haxeko/h2-thread-button/hardware-chip/fab/bom-jlcpcb.csv

Comment | Designator | Footprint | LCSC Part # | Manufacturer Part Number
22uF | C4 | 0603 | C59461 | CL10A226MQ8NRNC
1nF | C8 | 0402 | C1523 | 0402B102K500NT
10nF | C12 | 0402 | C15195 | CL05B103KB5NNNC
220uF | C1,C2 | 1210 | C469553 | GRM32ER60J227ME05L
18pF | C18,C19,C20,C21 | 0402 | C1549 | 0402CG180J500NT
1.5pF | C22,C23 | 0402 | C76957 | GRM1555C1H1R5BA01D
10uF | C3,C5,C6 | 0603 | C19702 | CL10A106KP8NNNC
1uF | C7,C10,C13 | 0402 | C52923 | CL05A105KA5NQNC
100nF | C9,C11,C14,C15,C16,C17,C26 | 0402 | C1525 | CL05B104KO5NNNC
XL-2121RGBC-WS2812B | D1 | SMD 2.1x2.1mm RGB LED | C5349957 | XL-2121RGBC-WS2812B
2.2uH | L1 | 1008 | C391305 | DFE252012P-2R2M=P2
24nH | L2 | 0402 | C74301 | SDCL1005C24NJTDF
2.4nH | L3 | 0402 | C97997 | LQG15HS2N4S02D
AO3401A | Q1,Q2 | SOT-23 | C15127 | AO3401A
36.5k | R1 | 0402 | C49010116 | FRC0402F3652TS
1k | R7 | 0402 | C11702 | 0402WGF1001TCE
100k | R8 | 0402 | C25741 | 0402WGF1003TCE
510R | R10 | 0402 | C25123 | 0402WGF5100TCE
100R | R12 | 0402 | C25076 | 0402WGF1000TCE
0R | R2,R3,R11 | 0402 | C17168 | 0402WGF0000TCE
10k | R4,R5 | 0402 | C25744 | 0402WGF1002TCE
1M | R6,R9 | 0402 | C26083 | 0402WGF1004TCE
PTS810 | SW1 | SMD 4.2x3.2mm tact switch | C116501 | PTS810 SJM 250 SMTR LFS
ESP32-H2FH4 | U1 | QFN-32 4x4mm | C22470214 | ESP32-H2FH4
TPS63900DSKR | U2 | WSON-10 2.5x2.5mm | C1518762 | TPS63900DSKR
32MHz | Y1 | SMD3225-4P | C90923 | 7M32000035
32.768kHz | Y2 | SMD3215-2P | C32346 | Q13FC13500004
