haxeko/h2-thread-button/hardware/fab/bom.csv

Qty | Designator | Value | Footprint | MPN | LCSC | Description | DNP
1 | BT1 | CR2032 | matter_button:BatteryHolder_Keystone_3034_CR2032 | Keystone 3034 |  | CR2032 holder, SMT
1 | C4 | 22uF | Capacitor_SMD:C_0603_1608Metric | CL10A226MQ8NRNC | C59461 | 6.3 V X5R, at U2 VOUT
1 | C7 | 1uF | Capacitor_SMD:C_0402_1005Metric | CL05A105KA5NQNC | C52923 | EN delay, not fitted | DNP
1 | C8 | 1nF | Capacitor_SMD:C_0402_1005Metric | CL05B102KB5NNNC | C1523 | 50 V X7R, button filter
2 | C1,C2 | 220uF | Capacitor_SMD:C_1210_3225Metric | GRM32ER60J227ME05L | C469553 | 6.3 V X5R bulk
2 | C3,C5 | 10uF | Capacitor_SMD:C_0603_1608Metric | CL10A106KP8NNNC | C19702 | 10 V X5R, at U1 pin 1,10 V X5R, at U2 VIN
2 | C6,C9 | 100nF | Capacitor_SMD:C_0402_1005Metric | CL05B104KO5NNNC | C1525 | 16 V X7R, VBAT sense filter,16 V X7R, at U1 pin 1
1 | D1 | red | LED_SMD:LED_0603_1608Metric | KT-0603R | C2286 | Hubei KENTO 0603 red
1 | L1 | 2.2uH | Inductor_SMD:L_1008_2520Metric | DFE252012P-2R2M=P2 | C391305 | Murata 2.5x2.0 mm, Isat 3 A
1 | Q1 | AO3401A | Package_TO_SOT_SMD:SOT-23 | AO3401A | C15127 | P-MOSFET -30 V, reverse polarity protection
1 | R1 | 36.5k | Resistor_SMD:R_0402_1005Metric | FRC0402F3652TS | C49010116 | 1 %, CFG1: VO(2) 3.3 V
2 | R2,R3 | 0R | Resistor_SMD:R_0402_1005Metric | 0402WGF0000TCE | C17168 | CFG2: no input current limit,CFG3: VO(1) 1.8 V, unused (SEL = VIN selects VO(2))
2 | R4,R5 | 10k | Resistor_SMD:R_0402_1005Metric | 0402WGF1002TCE | C25744 | EN pull-up,GPIO8 strapping pull-up
2 | R6,R9 | 1M | Resistor_SMD:R_0402_1005Metric | 0402WGF1004TCE | C26083 | VBAT sense, no divider,button pull-up
2 | R7,R8 | 1k | Resistor_SMD:R_0402_1005Metric | 0402WGF1001TCE | C11702 | LED series,button series
1 | SW1 | PTS810 | Button_Switch_SMD:SW_SPST_PTS810 | PTS810 SJM 250 SMTR LFS | C116501 | C&K 4.2x3.2 mm tact switch, 160 gf
1 | U1 | ESP32-H2-WROOM-02C-H4S | matter_button:ESP32-H2-WROOM-02C | ESP32-H2-WROOM-02C-H4S |  | Thread/BLE module, 4 MB flash
1 | U2 | TPS63900DSKR | Package_SON:WSON-10-1EP_2.5x2.5mm_P0.5mm_EP1.2x2mm | TPS63900DSKR | C1518762 | Buck-boost 1.8-5.5 V in, 75 nA Iq
