haxeko/h2-thread-button/hardware-chip/matter-button-cr2032-chip.kicad_pcb

## KiCad design hardware-chip/matter-button-cr2032-chip.kicad_pcb (2026-10-29)

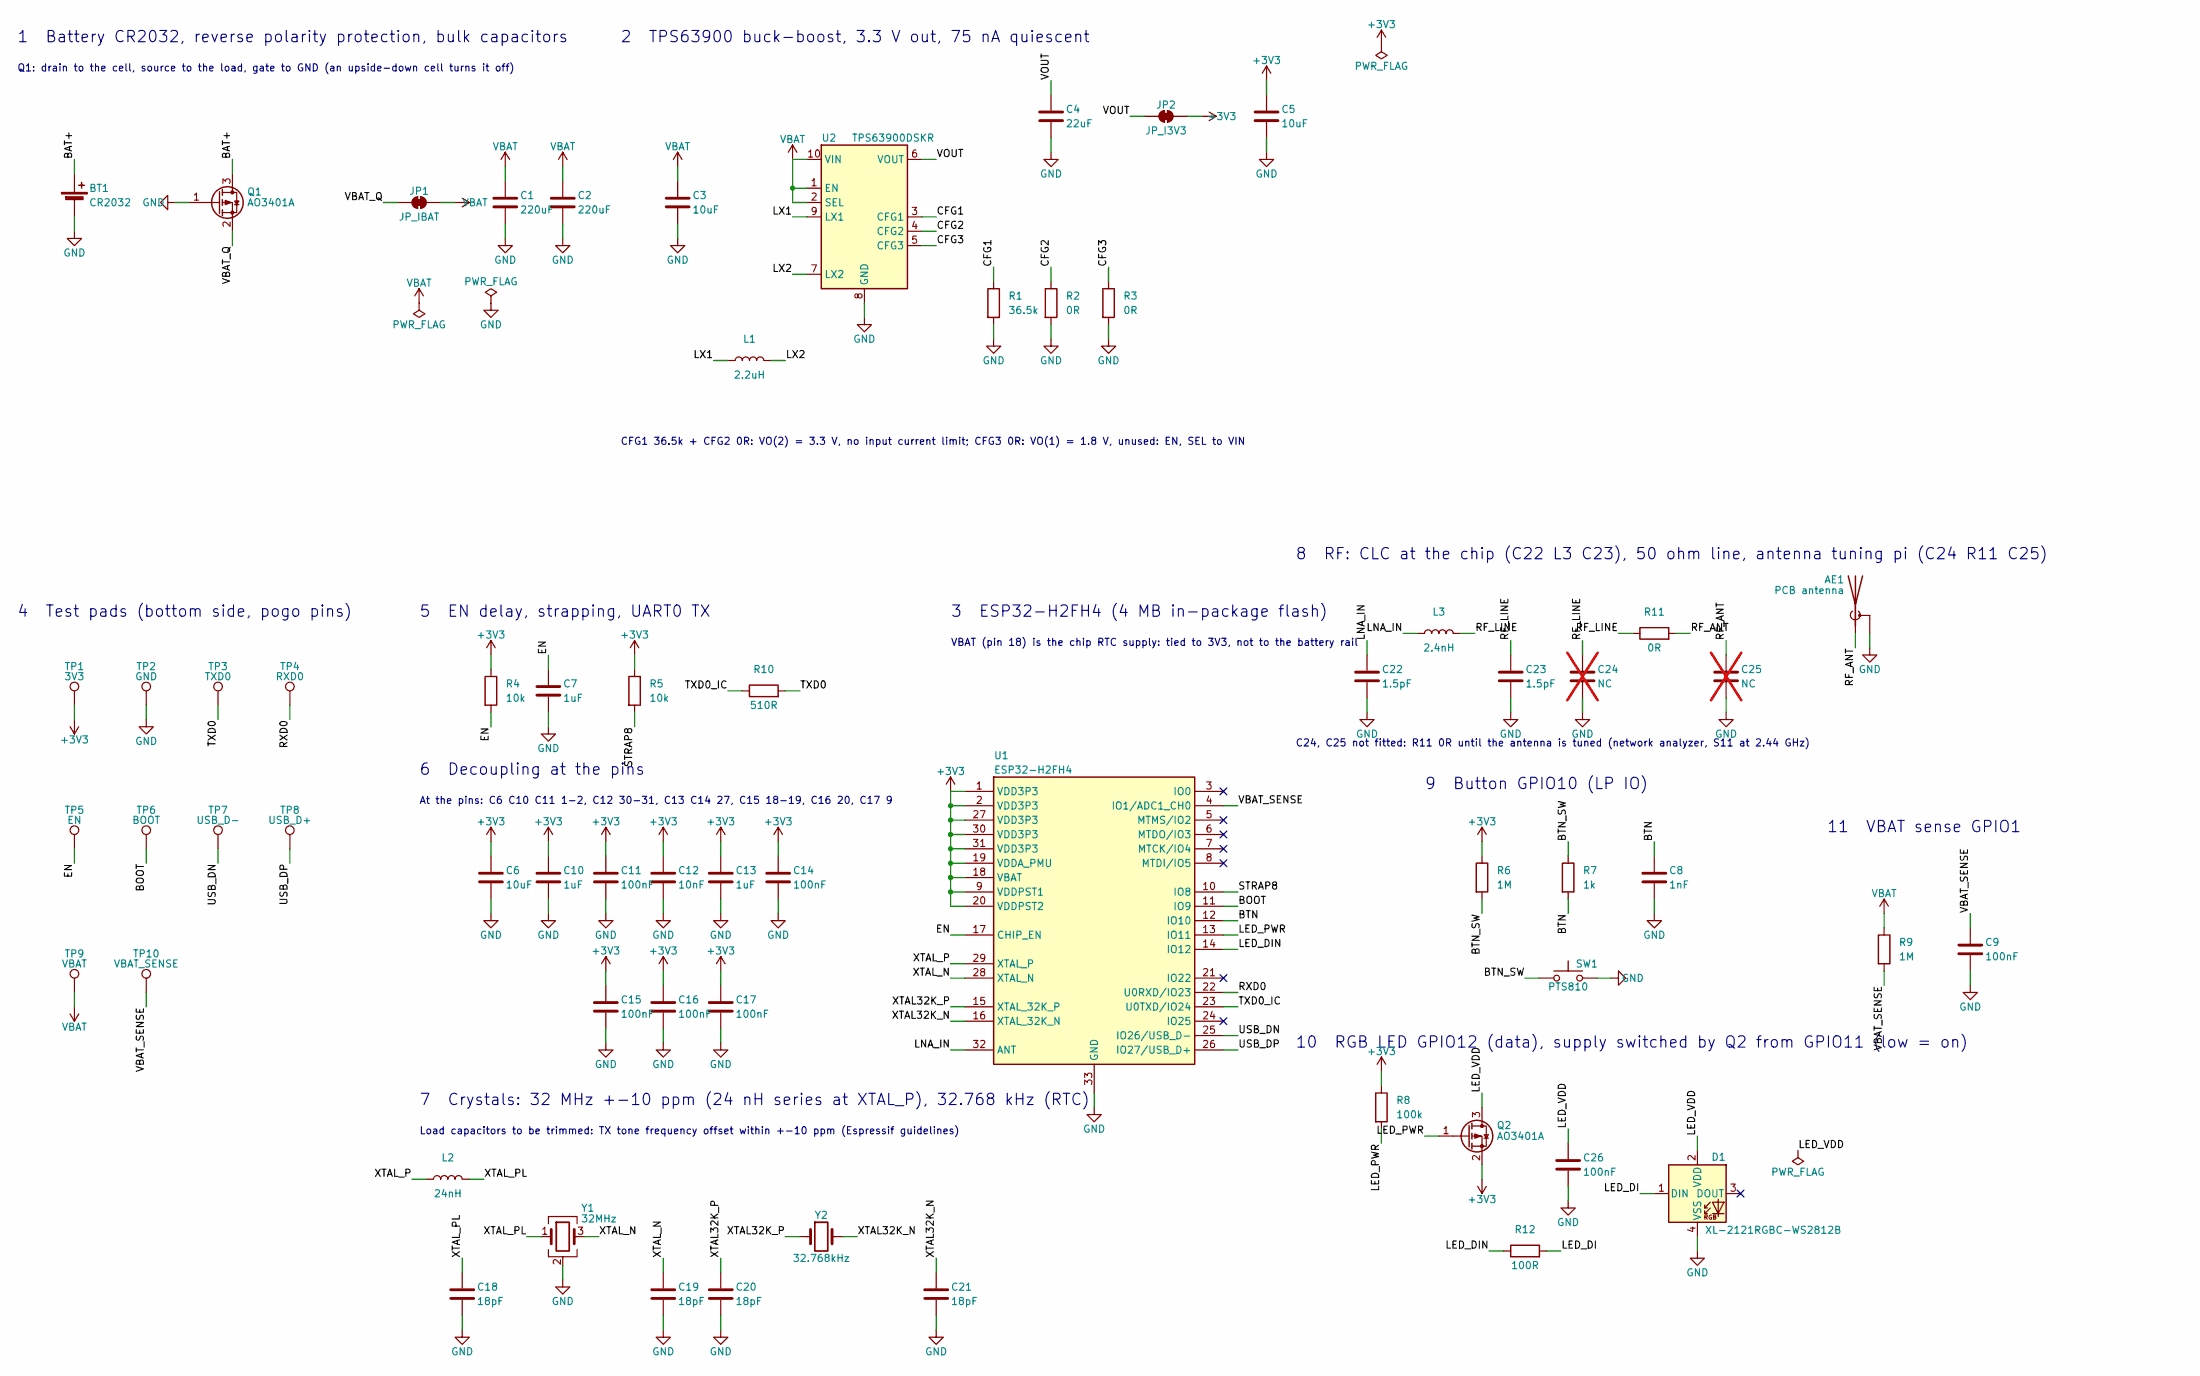
[picture p8: schematic matter-button-cr2032-chip.kicad_sch, ESP32-H2 Matter over Thread CR2032 button, chip and PCB ant…]

Parts:
AE1: PCB antenna; ANT_MIFA_TI-AN043
BT1: CR2032; BatteryHolder_Keystone_3034_CR2032; MPN Keystone 3034
C1, C2: 220uF; C_1210_3225Metric; MPN GRM32ER60J227ME05L; LCSC C469553
C3, C5, C6: 10uF; C_0603_1608Metric; MPN CL10A106KP8NNNC; LCSC C19702
C4: 22uF; C_0603_1608Metric; MPN CL10A226MQ8NRNC; LCSC C59461
C7, C10, C13: 1uF; C_0402_1005Metric; MPN CL05A105KA5NQNC; LCSC C52923
C8: 1nF; C_0402_1005Metric; MPN 0402B102K500NT; LCSC C1523
C9, C11, C14, C15, C16, C17, C26: 100nF; C_0402_1005Metric; MPN CL05B104KO5NNNC; LCSC C1525
C12: 10nF; C_0402_1005Metric; MPN CL05B103KB5NNNC; LCSC C15195
C18, C19, C20, C21: 18pF; C_0402_1005Metric; MPN 0402CG180J500NT; LCSC C1549
C22, C23: 1.5pF; C_0402_1005Metric; MPN GRM1555C1H1R5BA01D; LCSC C76957
C24, C25: NC; C_0402_1005Metric; not fitted
D1: XL-2121RGBC-WS2812B; LED_XL-2121RGBC-WS2812B_2.1x2.1mm; MPN XL-2121RGBC-WS2812B; LCSC C5349957
JP1: JP_IBAT; SolderJumper-2_P1.3mm_Bridged_RoundedPad1.0x1.5mm
JP2: JP_I3V3; SolderJumper-2_P1.3mm_Bridged_RoundedPad1.0x1.5mm
L1: 2.2uH; L_1008_2520Metric; MPN DFE252012P-2R2M=P2; LCSC C391305
L2: 24nH; L_0402_1005Metric; MPN SDCL1005C24NJTDF; LCSC C74301
L3: 2.4nH; L_0402_1005Metric; MPN LQG15HS2N4S02D; LCSC C97997
Q1, Q2: AO3401A; SOT-23; MPN AO3401A; LCSC C15127
R1: 36.5k; R_0402_1005Metric; MPN FRC0402F3652TS; LCSC C49010116
R2, R3, R11: 0R; R_0402_1005Metric; MPN 0402WGF0000TCE; LCSC C17168
R4, R5: 10k; R_0402_1005Metric; MPN 0402WGF1002TCE; LCSC C25744
R6, R9: 1M; R_0402_1005Metric; MPN 0402WGF1004TCE; LCSC C26083
R7: 1k; R_0402_1005Metric; MPN 0402WGF1001TCE; LCSC C11702
R8: 100k; R_0402_1005Metric; MPN 0402WGF1003TCE; LCSC C25741
R10: 510R; R_0402_1005Metric; MPN 0402WGF5100TCE; LCSC C25123
R12: 100R; R_0402_1005Metric; MPN 0402WGF1000TCE; LCSC C25076
SW1: PTS810; SW_SPST_PTS810; MPN PTS810 SJM 250 SMTR LFS; LCSC C116501
TP1: 3V3; TestPoint_Pad_D1.0mm
TP2: GND; TestPoint_Pad_D1.0mm
TP3: TXD0; TestPoint_Pad_D1.0mm
TP4: RXD0; TestPoint_Pad_D1.0mm
TP5: EN; TestPoint_Pad_D1.0mm
TP6: BOOT; TestPoint_Pad_D1.0mm
TP7: USB_D-; TestPoint_Pad_D1.0mm
TP8: USB_D+; TestPoint_Pad_D1.0mm
TP9: VBAT; TestPoint_Pad_D1.0mm
TP10: VBAT_SENSE; TestPoint_Pad_D1.0mm
U1: ESP32-H2FH4; ESP32-H2_QFN-32-1EP_4x4mm_P0.4mm; MPN ESP32-H2FH4; LCSC C22470214
U2: TPS63900DSKR; WSON-10-1EP_2.5x2.5mm_P0.5mm_EP1.2x2mm; MPN TPS63900DSKR; LCSC C1518762
Y1: 32MHz; Crystal_SMD_3225-4Pin_3.2x2.5mm; MPN 7M32000035; LCSC C90923
Y2: 32.768kHz; Crystal_SMD_3215-2Pin_3.2x1.5mm; MPN Q13FC13500004; LCSC C32346

Connections:
+3V3: C5.1, C6.1, C10.1, C11.1, C12.1, C13.1, C14.1, C15.1, C16.1, C17.1, JP2.2 (B), Q2.2 (S), R4.1, R5.1, R6.1, R8.1, TP1.1, U1.1 (VDD3P3), U1.2 (VDD3P3), U1.9 (VDDPST1), U1.18 (VBAT), U1.19 (VDDA_PMU), U1.20 (VDDPST2), U1.27 (VDD3P3), U1.30 (VDD3P3), U1.31 (VDD3P3)
/BAT+: BT1.1 (+), Q1.3 (D)
/BOOT: TP6.1, U1.11 (IO9)
/BTN: C8.1, R7.2, U1.12 (IO10)
/BTN_SW: R6.2, R7.1, SW1.1
/CFG1: R1.1, U2.3 (CFG1)
/CFG2: R2.1, U2.4 (CFG2)
/CFG3: R3.1, U2.5 (CFG3)
/EN: C7.1, R4.2, TP5.1, U1.17 (CHIP_EN)
/LED_DI: D1.1 (DIN), R12.2
/LED_DIN: R12.1, U1.14 (IO12)
/LED_PWR: Q2.1 (G), R8.2, U1.13 (IO11)
/LED_VDD: C26.1, D1.2 (VDD), Q2.3 (D)
/LNA_IN: C22.1, L3.1, U1.32 (ANT)
/LX1: L1.1, U2.9 (LX1)
/LX2: L1.2, U2.7 (LX2)
/RF_ANT: AE1.1 (A), C25.1, R11.2
/RF_LINE: C23.1, C24.1, L3.2, R11.1
/RXD0: TP4.1, U1.22 (U0RXD/IO23)
/STRAP8: R5.2, U1.10 (IO8)
/TXD0: R10.2, TP3.1
/TXD0_IC: R10.1, U1.23 (U0TXD/IO24)
/USB_DN: TP7.1, U1.25 (IO26/USB_D-)
/USB_DP: TP8.1, U1.26 (IO27/USB_D+)
/VBAT_Q: JP1.1 (A), Q1.2 (S)
/VBAT_SENSE: C9.1, R9.2, TP10.1, U1.4 (IO1/ADC1_CH0)
/VOUT: C4.1, JP2.1 (A), U2.6 (VOUT)
/XTAL32K_N: C21.1, U1.16 (XTAL_32K_N), Y2.2
/XTAL32K_P: C20.1, U1.15 (XTAL_32K_P), Y2.1
/XTAL_N: C19.1, U1.28 (XTAL_N), Y1.3
/XTAL_P: L2.1, U1.29 (XTAL_P)
/XTAL_PL: C18.1, L2.2, Y1.1
GND: AE1.2 (Shield), BT1.2 (-), C1.2, C2.2, C3.2, C4.2, C5.2, C6.2, C7.2, C8.2, C9.2, C10.2, C11.2, C12.2, C13.2, C14.2, C15.2, C16.2, C17.2, C18.2, C19.2, C20.2, C21.2, C22.2, C23.2, C24.2, C25.2, C26.2, D1.4 (VSS), Q1.1 (G), R1.2, R2.2, R3.2, SW1.2, TP2.1, U1.33 (GND), U2.8 (GND), U2.11 (GND), Y1.2 (G), Y1.4 (G)
VBAT: C1.1, C2.1, C3.1, JP1.2 (B), R9.1, TP9.1, U2.1 (EN), U2.2 (SEL), U2.10 (VIN)

Notes on the sheet:
1 Battery CR2032, reverse polarity protection, bulk capacitors
Q1: drain to the cell, source to the load, gate to GND (an upside-down cell turns it off)
2 TPS63900 buck-boost, 3.3 V out, 75 nA quiescent
CFG1 36.5k + CFG2 0R: VO(2) = 3.3 V, no input current limit; CFG3 0R: VO(1) = 1.8 V, unused: EN, SEL to VIN
4 Test pads (bottom side, pogo pins)
5 EN delay, strapping, UART0 TX
6 Decoupling at the pins
At the pins: C6 C10 C11 1-2, C12 30-31, C13 C14 27, C15 18-19, C16 20, C17 9
7 Crystals: 32 MHz +-10 ppm (24 nH series at XTAL_P), 32.768 kHz (RTC)
Load capacitors to be trimmed: TX tone frequency offset within +-10 ppm (Espressif guidelines)
3 ESP32-H2FH4 (4 MB in-package flash)
VBAT (pin 18) is the chip RTC supply: tied to 3V3, not to the battery rail
8 RF: CLC at the chip (C22 L3 C23), 50 ohm line, antenna tuning pi (C24 R11 C25)
C24, C25 not fitted: R11 0R until the antenna is tuned (network analyzer, S11 at 2.44 GHz)
9 Button GPIO10 (LP IO)
11 VBAT sense GPIO1
10 RGB LED GPIO12 (data), supply switched by Q2 from GPIO11 (low = on)

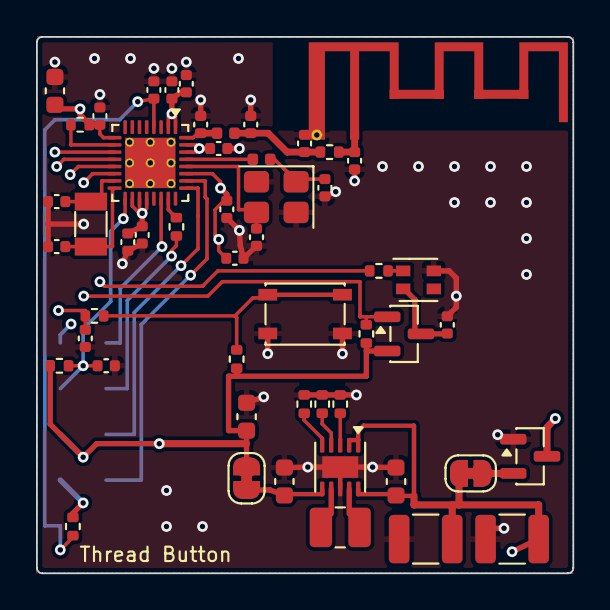
[picture p9: board matter-button-cr2032-chip.kicad_pcb from above]

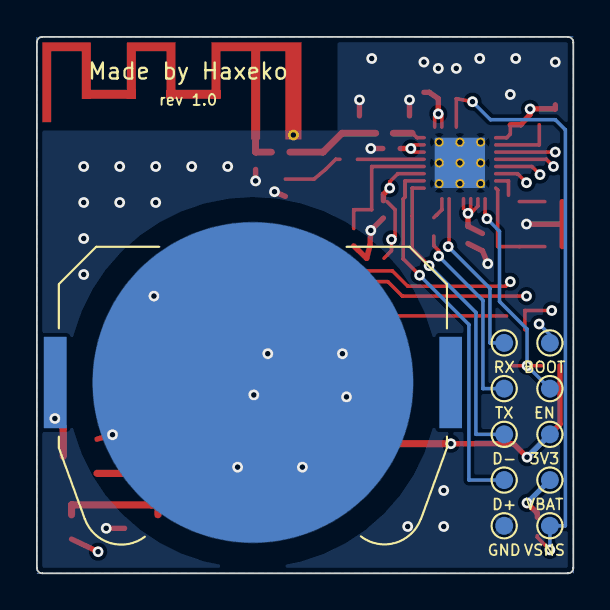
[picture p10: board matter-button-cr2032-chip.kicad_pcb from below]

Board: 4 copper layers, 29.8 x 29.8 mm, 63 parts (11 on the bottom side), 34 nets.
