haxeko/h2-thread-button/(commit log)

2026-10-17 ESP32-H2 Matter over Thread CR2032 button (Generic Switch, SED + ICD)
    New project ESP32-H2/matter-thread/matter-button-cr2032: battery button on
    ESP32-H2-WROOM-02C powered by a CR2032 through a TPS63900 buck-boost.
    - Generic Switch endpoint (MS|MSR|MSL|MSM, MultiPressMax 2): single, double
    and long press as the Switch events Apple Home and Home Assistant use;
    hold 10 s opens a commissioning window, 20 s factory reset
    - Button driver without polling: level interrupt + EXT1 (LP IO) wakeup,
    debounce and gestures in a host-tested state machine (17 cases)
    - Thread SED + Matter ICD: SIT by default (every controller), LIT + DSLS
    overlay that stays SIT while any fabric has no Check-In clien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
    [partitions.csv]
2026-10-17 matter-button-cr2032: fix boot factory reset and review findings
    - Factory reset on every boot: boot_reset_requested() read GPIO10 before
    the pad was configured. Its input buffer is off after reset (ESP32-H2
    datasheet Table 2-1), gpio_get_level() returns 0, which is "pressed"
    for this active-low button. button_gpio_init() now configures the pad
    first thing in app_main().
    - Low-battery boot guard: arm the EXT1 button wakeup only with the
    external pull-up and the button released, so a held or stuck button
    cannot wake the chip again and again.
    - Detached policy: also start when the device boots without a network
    (no connectivity change is ever posted then), and re-check after 5 mi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
2026-10-23 matter-button-cr2032: drawn schematic (SVG/PNG) and its generator
    docs/schematic.svg and .png, drawn by tools/schematic.py (schemdraw) with
    the README BOM designators and values: battery and reverse-polarity
    MOSFET, bulk capacitors, TPS63900 configuration, ESP32-H2-WROOM-02C with
    the button, LED, VBAT sense, strapping and test pads. README section 3.1
    shows it above the text version.
    Claude-Session: https://claude.ai/code/session_01R15P3zWK2KCijMWrCL7LHn
2026-10-23 matter-button-cr2032: KiCad 9 schematic and 2-layer PCB
    hardware/ holds the KiCad project of the CR2032 button, generated by
    scripts from one data file (scripts/design.py):
    - gen_project.py: design rules and net classes, project library with
    the ESP32-H2-WROOM-02C symbol and footprint (datasheet v1.2 land
    pattern), a VBAT power symbol and the Keystone 3034 holder with one
    numbered tab.
    - gen_sch.py: A3 schematic, ERC clean.
    - gen_pcb.py: 30 x 38 mm board from the kicad-cli netlist, module
    antenna over the top edge, holder on the bottom side, test pads on a
    2.54 mm grid; the TPS63900 area, 3V3 trunk, button, LED and battery
    path are hand-routed, FreeRouting routes the rest, GND p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
    [bom.csv, matter-button-cr2032.kicad_pcb, matter-button-cr2032.kicad_sch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]
2026-10-26 matter-button-cr2032: BOM by component name and specs (Vietnamese)
    fab/bom-vi.csv lists every part by name, value, package, search
    keywords and substitutes, for buying without the manufacturer part
    numbers. UTF-8 with BOM so Excel shows the Vietnamese text.
    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
    [bom-vi.csv]
2026-10-28 matter-button-cr2032: JLCPCB BOM and CPL, Gerber without X2 attributes
    - fab/bom-jlcpcb.csv: assembled parts only, JLCPCB columns (Comment,
    Designator, Footprint, LCSC Part #) plus the MPN for parts matching.
    - fab/cpl-jlcpcb.csv replaces fab/cpl.csv: Designator, Mid X, Mid Y,
    Layer, Rotation, coordinates in mm.
    - Gerber exported as in the JLCPCB KiCad guide: Protel names, no X2
    and netlist attributes.
    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
    [bom-jlcpcb.csv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]
2026-10-28 matter-button-cr2032: JLCPCB Basic parts and LCSC part numbers
    Every assembled part now carries an LCSC part number (schematic field,
    footprint field, BOM). Common parts moved to the JLCPCB Basic library:
    - Q1 AO3401A (C15127) instead of DMG2305UX, same SOT-23 pinout
    - D1 KT-0603R (C2286), passives UNI-ROYAL / Samsung Basic parts
    - R3 (CFG3) 0 ohm as the TI 3.3 V reference design: VO(1) = 1.8 V,
    unused because SEL is tied to VIN; R2 and R3 share one part
    - R6 button pull-up 1 Mohm (same part as R9): 3.3 uA while pressed
    Extended parts left: U2, L1 (DFE252012P-2R2M), C1/C2, R1 36.5k, SW1
    (PTS810 SJM, 160 gf). U1 and BT1 are not stocked by LCSC: left out of
    the JLCPCB BOM and CPL, hand solde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
    [bom-jlcpcb.csv, bom-vi.csv, bom.csv, matter-button-cr2032.kicad_pcb, matter-button-cr2032.kicad_sch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]
2026-10-28 matter-button-cr2032: compact 25 x 27 mm PCB
    Same schematic, new layout: the CR2032 holder moves under the module and
    the circuit, the board shrinks from 30 x 38 to 25 x 27 mm (41 % less area).
    - the holder (23.2 mm between its tab ends) sets the width; the cell edge
    is now 6.5 mm from the antenna feed (was ~16 mm), the docs ask for an
    RSSI/LQI check and point to the previous layout as fallback
    - bottom side: no copper in a ring around the cell edge (the + can), GND
    vias only inside the contact pad or outside the cell
    - test pads stay on the bottom side under the module (2 x 5, 2.54 x 2.7 mm)
    - gen_pcb.py: new placement and hand routes, coin-cell ring rule areas,
    duplicate segment cl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
    [matter-button-cr2032.kicad_pcb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]
2026-10-28 matter-button-cr2032: 29.8 x 23.9 mm PCB, under 30 x 30 mm with the antenna
    Same schematic, new layout so the whole board including the module antenna
    overhang fits in 30 x 30 mm (29.8 x 29.9 mm), no mounting holes.
    - module at the top right edge, passives and the TPS63900 on its left,
    button in the middle, battery input and sense on the right
    - the cell edge is now 3.4 mm from the antenna base (25 x 27 mm: 6.5 mm);
    the docs ask for an RSSI/LQI check and point to the earlier layouts
    - test pads: 2 x 2 in each top corner, RX and VBAT right of the holder;
    every signal is routed in the script, so the route stage skips
    FreeRouting when only GND (the pours) is left
    - silkscreen: "Thread B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
    [matter-button-cr2032.kicad_pcb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]
2026-10-29 matter-button-cr2032: chip-down board (ESP32-H2 chip, PCB antenna, WS2812B LED)
    hardware-chip/: a variant of the button without the WROOM module, generated by
    scripts like hardware/ (ERC 0, DRC 0 with schematic parity, KiCad 9.0.9):
    - ESP32-H2FH4 QFN32 with its 32 MHz crystal (24 nH at XTAL_P), a 32.768 kHz
    crystal, decoupling per the Espressif reference, CLC at the RF pin, a 50 ohm
    grounded coplanar line and a pi tuning network at the feed of a printed
    TI AN043 inverted F antenna
    - XL-2121RGBC-WS2812B RGB LED (no WS2812-type LED is a JLCPCB Basic part),
    data on GPIO12, supply switched by a P-MOSFET from GPIO11
    - battery, TPS63900, button, battery sense and test pads as the module bo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
    [bom-jlcpcb.csv, bom-vi.csv, bom.csv, matter-button-cr2032-chip.kicad_pcb, matter-button-cr2032-chip.kicad_sch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]
2026-11-05 matter-button-cr2032: steadier battery percentage
    Taking the cell out and back in lowered BatPercentRemaining by ~10 % each
    time: the boot reading is taken under load (CPU running, C9 still charging)
    and the first rest reading came 2 min after boot, during the attach and the
    commissioning window, while a CR2032 reads low for minutes after radio
    bursts.
    - The boot reading feeds the boot guard only. The reported rest voltage,
    percentage and level are saved in NVS (namespace "battery", kept by a
    factory reset) and reported again after a battery change until the first
    rest reading; with nothing saved the percentage stays null.
    - Rest readings wait until no commissioning window or OTA down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
2026-11-05 matter-button-cr2032: Deep-sleep while uncommissioned, esp_pm diagnostics
    An uncommissioned device drew ~4 mA all night: esp-matter keeps the BLE
    controller initialised until a fabric exists, and with the main XTAL as the
    BLE low-power clock (CONFIG_BT_LE_LP_CLK_SRC_MAIN_XTAL, the module board has
    no 32 kHz crystal) the XTAL stays on in Light-sleep: 4.0 mA instead of 24 uA
    on ESP32-H2 (ESP-IDF examples/bluetooth/nimble/power_save README). That is
    ~40-50 mAh per night, a quarter of a CR2032.
    - power.cpp: 60 s after the commissioning window closed without a
    commissioning (and no PASE session / fail-safe in progress), Deep-sleep
    (~7 uA) with EXT1 wake on the button; the press restarts the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
2026-11-06 matter-button-cr2032: README/checklist: what the battery percentage can and cannot show
    The percent table is 0.3 %/mV near the top, a 100 % -> 93 % step is ~23 mV
    (the ADC error): expected on a fresh cell's first night, and a 1-5 mA drain
    would still read 85-100 %; only >= ~10 mA continuous is excluded by the
    reading. Checklist F13: compare the DMM at TP9 with the logged rest mV.
    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
2026-11-06 matter-button-cr2032: checklist B4: EN-low current stated at JP1
    With EN held low, R4 and the module's EN pull-up draw 0.33-0.66 mA from
    the 3.3 V rail, about 0.4-0.9 mA at JP1, which hides any uA leakage.
    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
2026-11-06 matter-button-cr2032: battery readings every 12 h again, follow-up readings
    pdMS_TO_TICKS() multiplies in 32 bits, so at 1000 Hz the 12 h interval
    wrapped to 250 s: a reading every ~4 min, the 500 ms load test every
    ~8 min (~14 uA). All delays in battery.cpp now convert in 64 bits, with
    static_asserts on the Kconfig maxima.
    After the first reading after a boot, two follow-up readings 60 min
    apart: the first one may come right after a commissioning or a flash,
    before the cell recovered, and a higher reading is reported at once.
    README: the bug in builds up to 1.0.2611052141, flash with flash_args
    to keep the pairing and the saved percentage. Checklist I7: schedule.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
2026-11-06 matter-button-cr2032: battery percentage from the charge used
    A CR2032 at ~60 uA sits on a flat ~2.95-3.0 V plateau for most of its
    life, and a new cell falls ~0.1 V within its first mAh: the voltage
    table showed 100 % falling to ~87 % in a day, then nothing for months.
    BatPercentRemaining is now the charge used (running time x
    BATTERY_MODEL_AVG_UA, default 60 uA) out of the usable capacity
    (BATTERY_CAPACITY_MAH x BATTERY_USABLE_PERCENT), saved in NVS. The
    reported rest voltage only bounds it: capped below the plateau so the
    end of life still shows, floored at 20 % on the plateau so an
    over-counting model cannot show an empty cell. A power-on reset with a
    rest reading >= 3020 mV, or 60 mV a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
2026-11-06 matter-button-cr2032: CR2450 option, percentage even down to 20 %, then by voltage
    BatPercentRemaining now falls evenly from 100 % to BATTERY_MODEL_FLOOR_PERCENT
    (20 %) over the nominal capacity at the modelled average current, then
    stays there: only the measured rest voltage takes it lower, once the
    cell leaves its plateau (2.9 V -> 2.85 V caps 100 % -> 20 %, then 20 % ->
    0 % at 2.4 V). A device drawing more than modelled reaches the knee
    early and is pulled down by the voltage.
    Kconfig choice BATTERY_CR2032 / BATTERY_CR2450 sets BatIECDesignation and
    the default capacity (220 / 620 mAh); sdkconfig.defaults.cr2450 selects
    it. BATTERY_USABLE_PERCENT is replaced by the floor.
    Co-Authored-By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
2026-11-06 matter-button-cr2032: battery percentage always shown, readings robust to sag
    BatPercentRemaining comes from the charge count, so it is published from
    the boot on: without saved values (a full image written at 0x0 erases
    NVS) the count starts at 0 and shows 100 % at once. Before, it stayed
    null until the first rest reading, and every button press pushed that
    reading back by the quiet time.
    Many presses in a row leave a coin cell low for tens of minutes:
    - rest readings wait 30 min without activity (was 10), up to 12 h
    - a lower reading is reported only once 3 readings in a row are lower
    AND span 24 h (BATTERY_DROP_CONFIRM_HOURS), so night readings are in
    it; the 60-min confirmation loop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
2026-11-06 matter-button-cr2032: ignore sdkconfig.<variant>.old
    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
2026-11-06 matter-button-cr2032: back to firmware 1.0.2611060757
    Reverts aa7fed1 (battery percentage always shown, readings robust to sag)
    and 3117530 (.gitignore): the project returns to the state of 52d9d34,
    the version merged into main.
    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
2026-11-08 matter-door-sensor: door sensor firmware on the button board, no button
    A fork of matter-button-cr2032 firmware 1.0.2611060757 for the same PCB with
    a reed switch soldered in parallel with SW1 (BTN_SW to GND, R6 1 MOhm
    pull-up, GPIO10):
    - Matter Contact Sensor (0x0015) on endpoint 1: Boolean State, StateValue
    true = closed (magnet at the reed), StateChange event on each change
    - contact.cpp / contact_fsm.cpp replace the button driver and its gesture
    FSM: 50 ms debounce, level interrupt + EXT1 wakeup on the opposite level,
    so the chip Light-sleeps with the door open or closed for hours;
    normally open or normally closed reed (CONTACT_CLOSED_WHEN_LOW)
    - pairing without a button: boot w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
2026-11-09 matter-button-cr2032: README 2.8, bulk capacitor 2 x 220 uF ceramic vs 470 uF
    Comparison with haxeko/matter-temperature-sensor (same CR2450 -> TPS63900
    path, 10 + 2 x 100 + 470 uF, +5 dBm): effective capacitance, ESR, leakage,
    height, JLCPCB price, failure modes, and a simulation of both devices
    (tools/capsim.py: the power_model.py equations of that repo plus an ESR
    branch; it reproduces 9/9 rows of its Rev B table). Short events gain
    from 470 uF late in the cell life and in the cold; boot and Thread
    re-attach do not depend on the capacitor. Recommendation: keep 2 x 220 uF
    on the button and door sensor (add a low-leakage 470 uF for margin), keep
    470 uF on the temperature sensor and lower its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
2026-11-11 Button: send a gesture again when no controller could receive it
    After a long idle the first press only brought the controller back and
    the second press was the one that worked. Switch events reach only the
    subscriptions established when they are generated; read later in a
    priming report, Apple Home takes them as historical and runs nothing.
    The gesture is now watched until a controller acknowledges it:
    - gesture_replay (pure C++17, host tested) decides per gesture. The
    event controllers act on (MultiPressComplete, LongPress) is generated
    at once for an established subscription, held back while one is being
    set up, and generated for the log only when nobody listens.
    - A gesture is de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
2026-11-11 Standalone repository: CI workflow, manufacturing tool, paths
    The project comes from haxeko/esp32-iot-project
    (ESP32-H2/matter-thread/matter-button-cr2032, branch
    claude/matter-button-cr2032), with its history. In this repository it
    sits at the root:
    - .github/workflows/build.yml: the project's workflow (host tests,
    battery model, firmware builds default / lit / chip) with paths from
    the root.
    - tools/matter-mfg: the factory data scripts the README uses for the
    factory variant (-t switch), copied from ESP32-H2/tools/matter-mfg.
    - README build commands, hardware README paths and links to the door
    sensor firmware and the multi-device audit, which stay in
    esp32-iot-project.
    Co-Autho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
